rumblelab/rainbow-maker/cards/rainbow_cards_fold.pdf

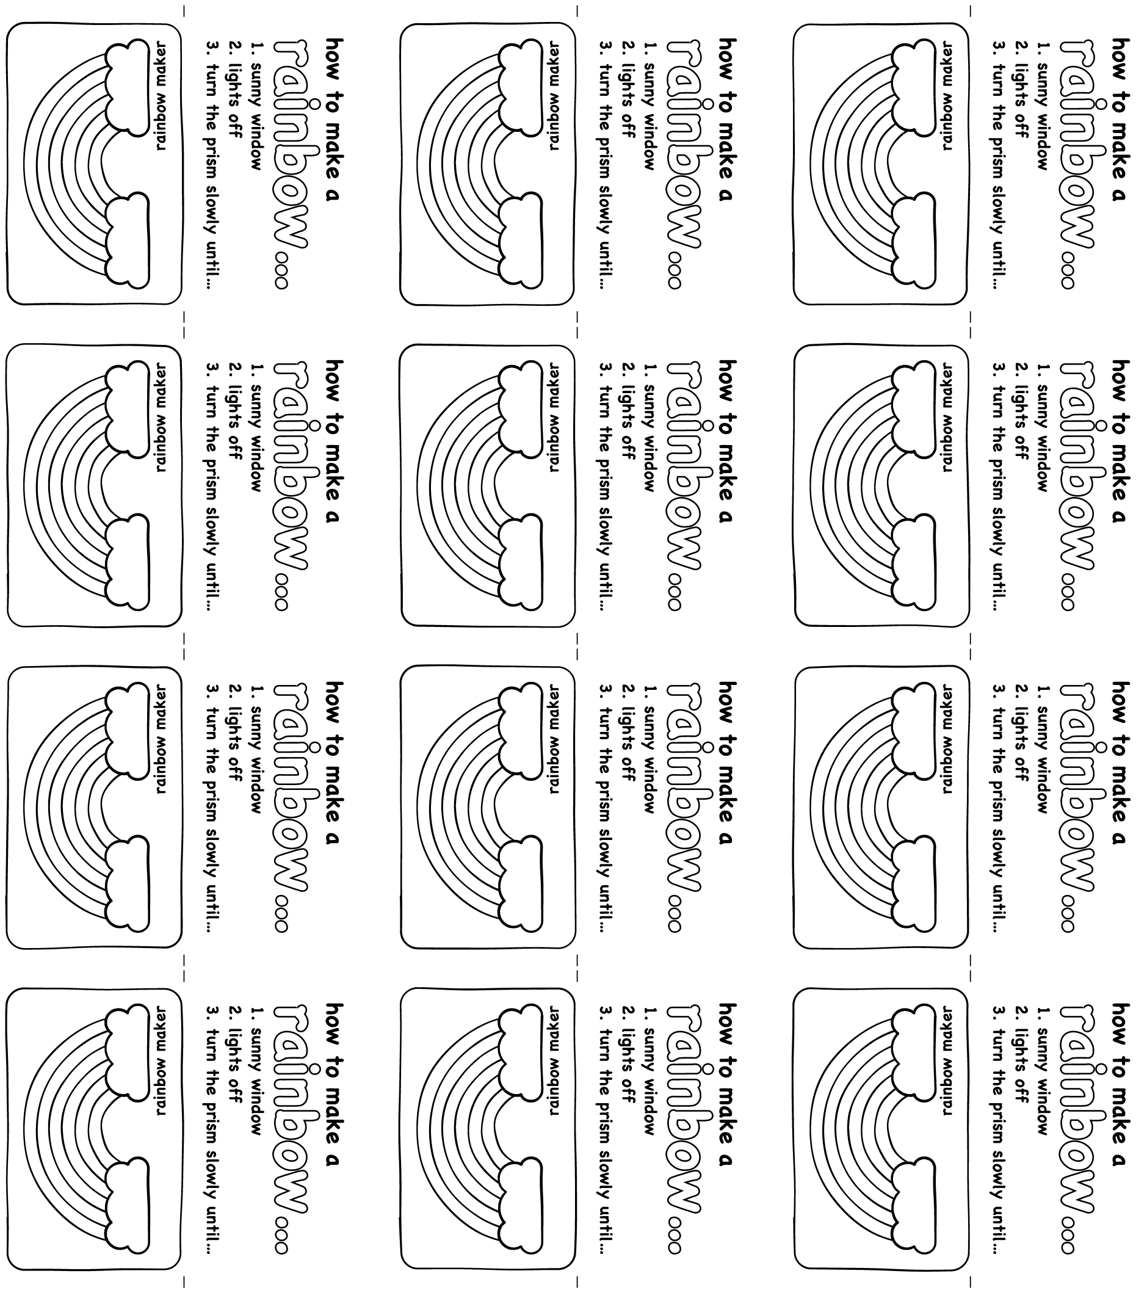
[picture p3: page 1]
