rumblelab/rainbow-maker/stl/pin.stl

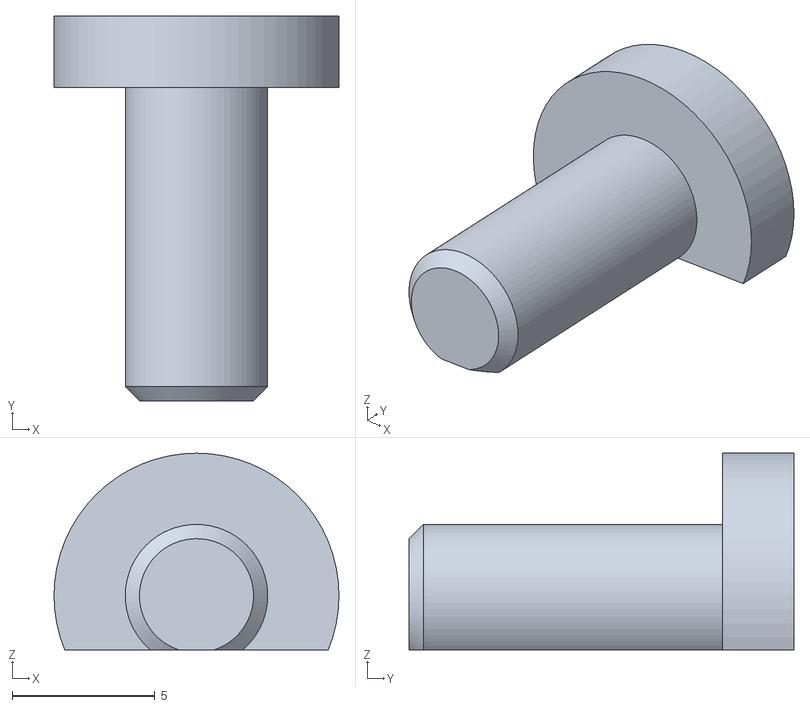
[picture p4: CAD file, 2026-10-05]
stl/pin.stl
10.0 x 13.5 x 6.90
