rumblelab/rainbow-maker/stl/tools/cup_gauge.stl

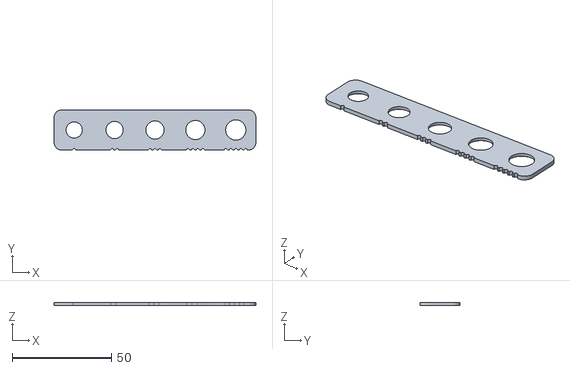
[picture p5: CAD file, 2026-10-05]
stl/tools/cup_gauge.stl
101.6 x 20.3 x 1.70
