rumblelab/rainbow-maker/stl/foot.stl

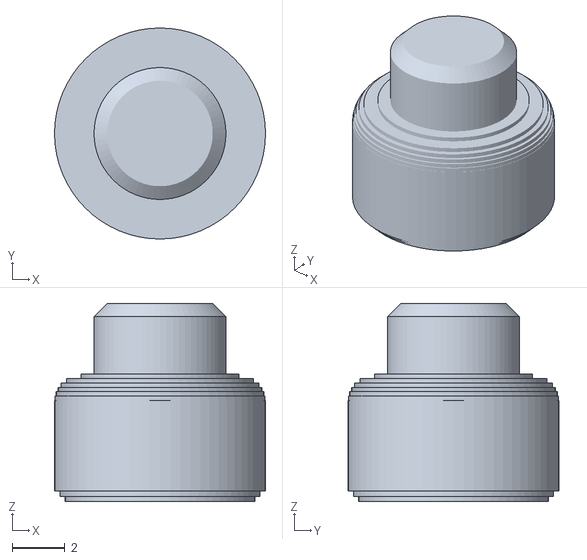
[picture p6: CAD file, 2026-10-05]
stl/foot.stl
8.00 x 8.00 x 7.52
