rumblelab/rainbow-maker/stl/tools/fit_gauge.stl

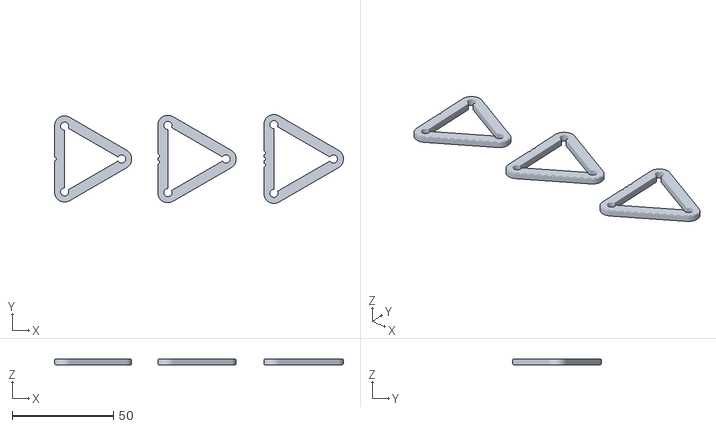
[picture p7: CAD file, 2026-10-05]
stl/tools/fit_gauge.stl
142.8 x 43.9 x 3.01
