rumblelab/rainbow-maker/stl/small_parts.stl

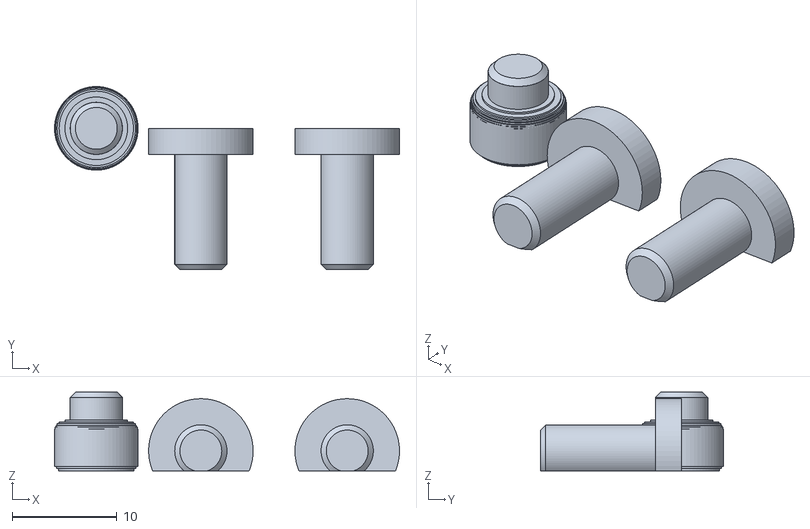
[picture p8: CAD file, 2026-10-05]
stl/small_parts.stl
33.0 x 17.5 x 7.52
