rumblelab/rainbow-maker/stl/holder.stl

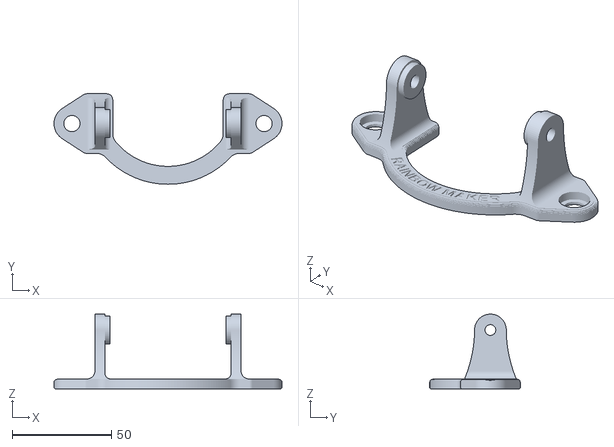
[picture p9: CAD file, 2026-10-05]
stl/holder.stl
114.6 x 45.5 x 37.6
