rumblelab/rainbow-maker/stl/cap.stl

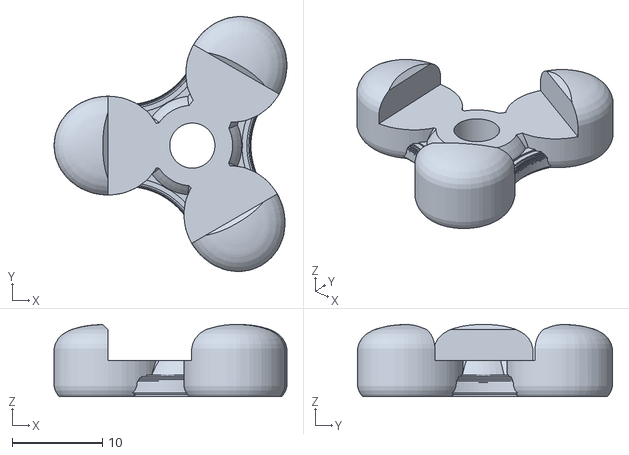
[picture p10: CAD file, 2026-10-05]
stl/cap.stl
25.8 x 28.3 x 7.98
